okie1/weatherstation/images/SketchOfPole.PNG

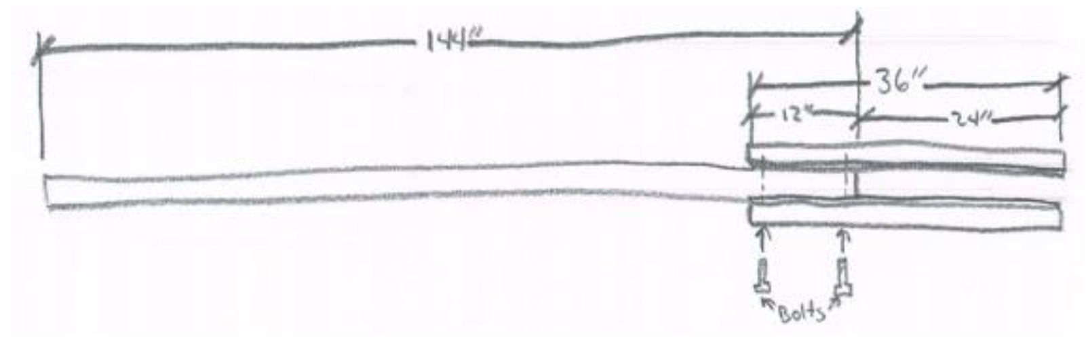
images/SketchOfPole.PNG
